S-T-R-I-K-E-Aerospace/Cansat_Huitzilin/Documentacion/CADGeneral.png

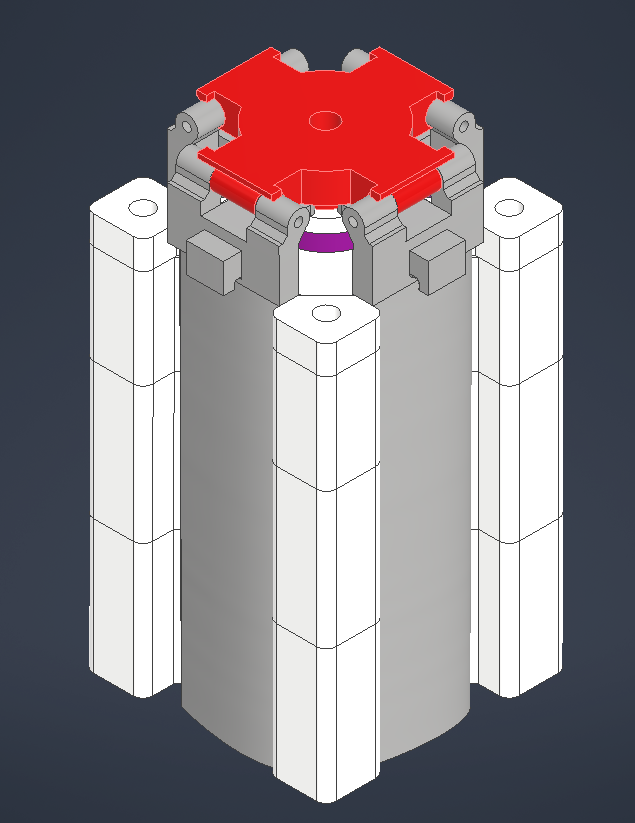
Documentacion/CADGeneral.png
