S-T-R-I-K-E-Aerospace/Cansat_Huitzilin/Documentacion/Semillas y AGua.png

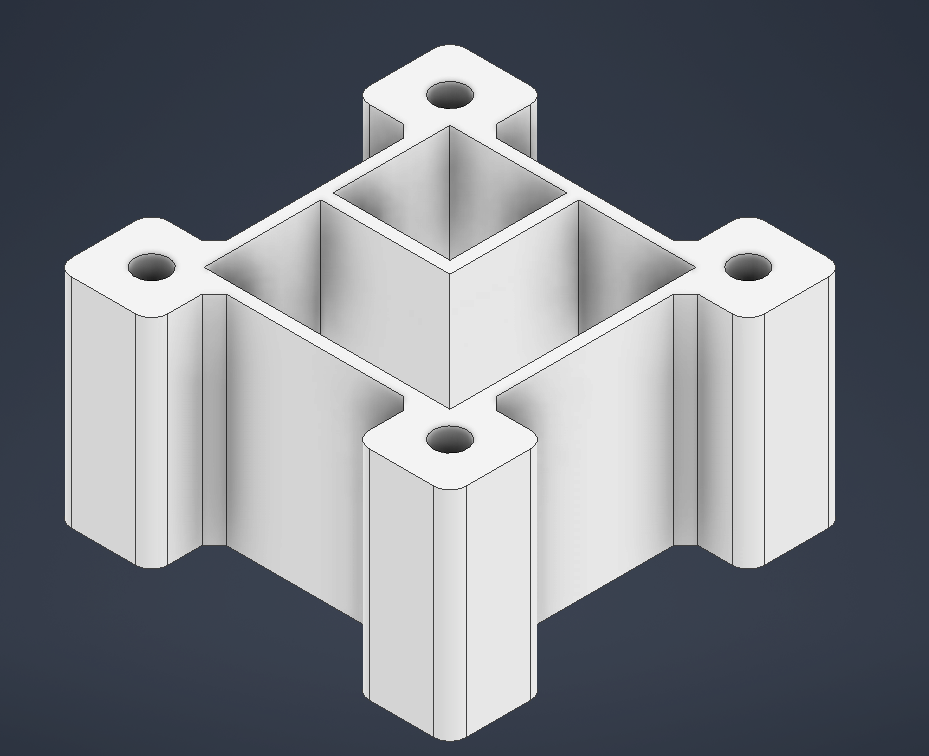
Documentacion/Semillas y AGua.png
