S-T-R-I-K-E-Aerospace/Cansat_Huitzilin/Documentacion/Huevo.png

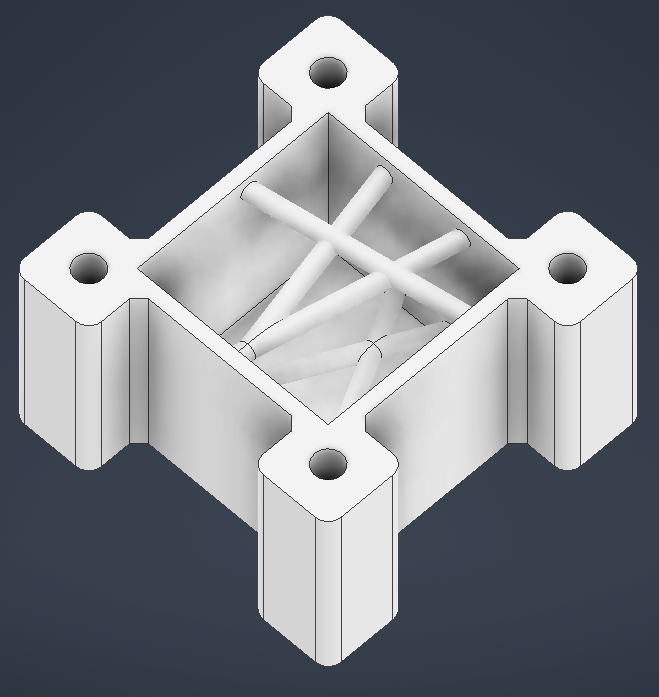
Documentacion/Huevo.png
