S-T-R-I-K-E-Aerospace/Cansat_Huitzilin/Documentacion/interfaz.png

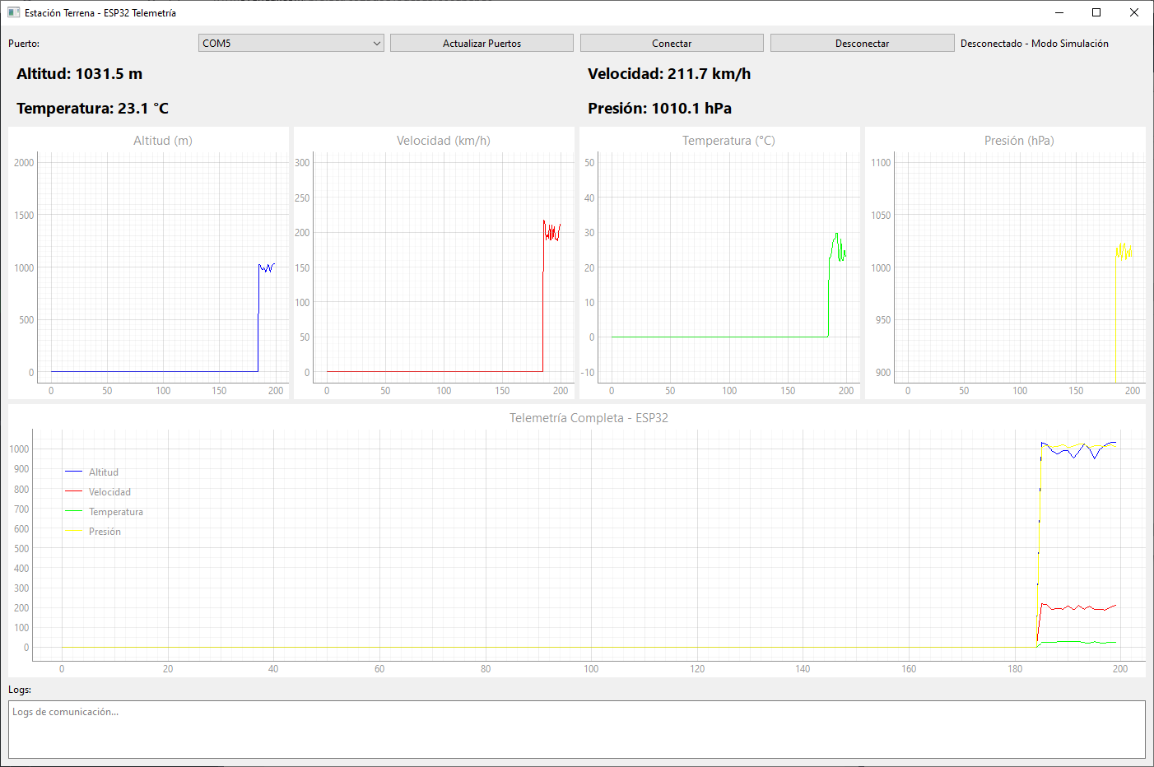
Documentacion/interfaz.png
