S-T-R-I-K-E-Aerospace/Cansat_Huitzilin/Documentacion/PalaDelantera.png

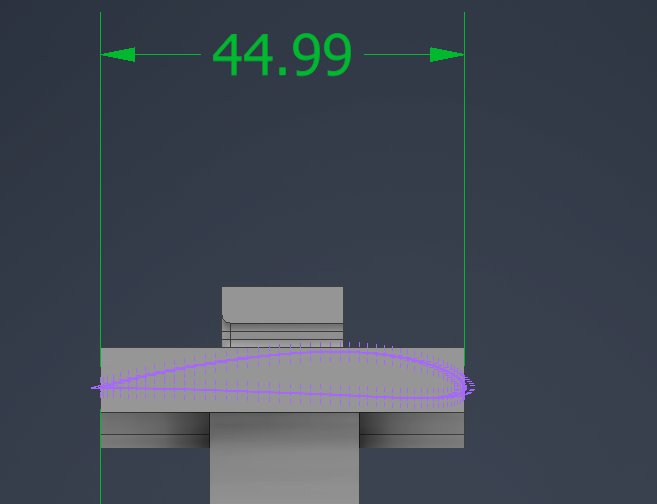
Documentacion/PalaDelantera.png
