S-T-R-I-K-E-Aerospace/Cansat_Huitzilin/Documentacion/Palalateral.png

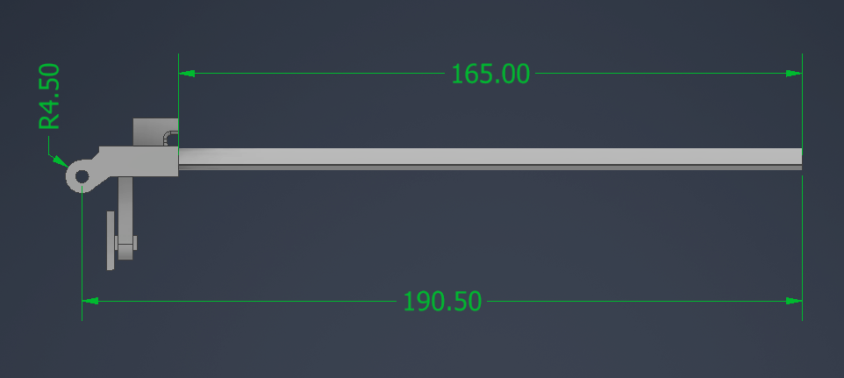
Documentacion/Palalateral.png
