S-T-R-I-K-E-Aerospace/Cansat_Huitzilin/Documentacion/Sistema Autogiro.png

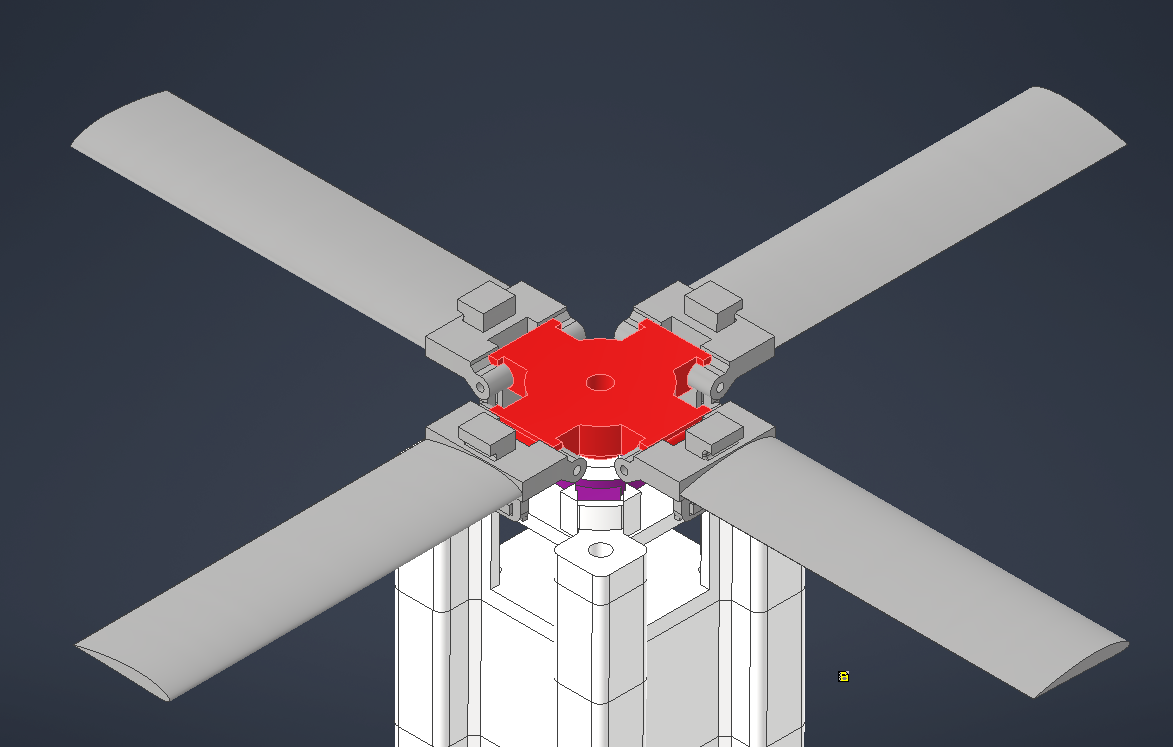
Documentacion/Sistema Autogiro.png
