S-T-R-I-K-E-Aerospace/Cansat_Huitzilin/(list of files, cad)

Other CAD files:
3D/Cansat armado.iam
3D/NuevoDiseno/628-ZZ-TheTimkenCompany-3D-01-17-2026.ipt
3D/NuevoDiseno/Arandela1-4.ipt
3D/NuevoDiseno/ArandelaDeCaucho.ipt
3D/NuevoDiseno/ArmellaCerrada.ipt
3D/NuevoDiseno/Huevo.ipt
3D/NuevoDiseno/Pala.ipt
3D/NuevoDiseno/SistemLiberacion1.ipt
3D/NuevoDiseno/SistemaDeDesacople.ipt
3D/NuevoDiseno/SubSistemaLiberacion.iam
3D/NuevoDiseno/SujeccionHelices.ipt
3D/NuevoDiseno/Tuerca1-4.ipt
3D/Pieza1.ipt
3D/Pieza2.ipt
3D/Pieza3.ipt
3D/Pieza4.ipt
3D/Pieza5.ipt
3D/Pieza6.ipt
3D/Pieza7.ipt
3D/Pieza8.ipt
3D/Pieza9.ipt
