S-T-R-I-K-E-Aerospace/Cansat_Huitzilin/PCB/Cansat_Huitzilin/Cansat_Huitzilin.kicad_pcb

## KiCad design PCB/Cansat_Huitzilin/Cansat_Huitzilin.kicad_pcb (2026-04-22)

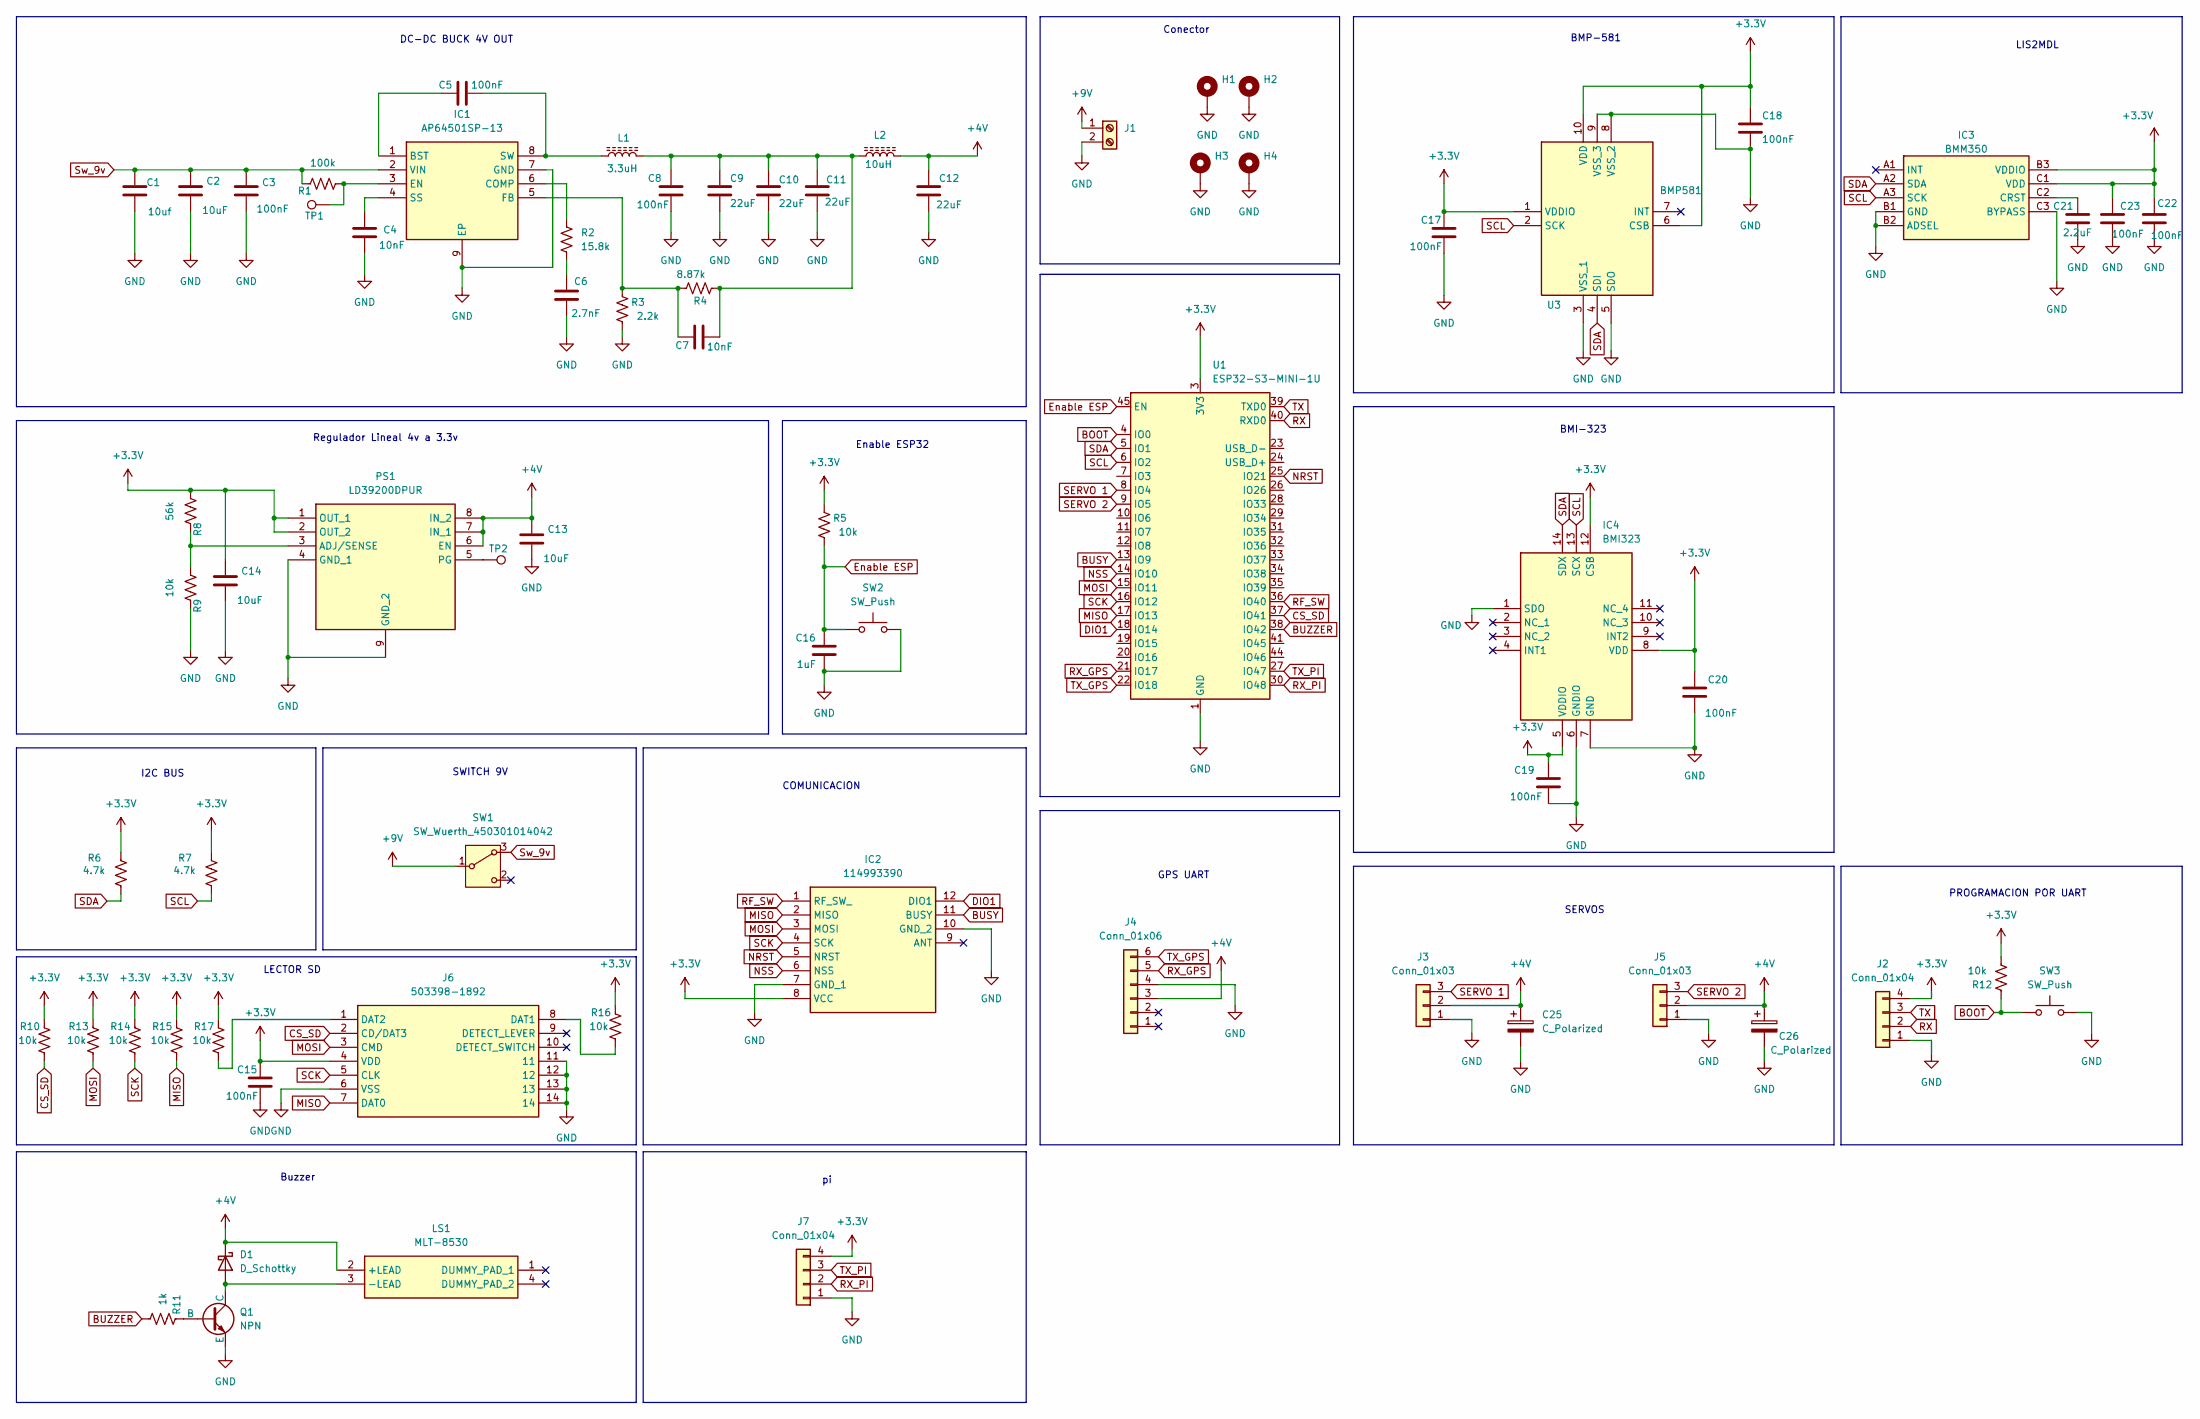
[picture p8: schematic Cansat_Huitzilin.kicad_sch, SCH_Cansat-Huitzilin]

Parts:
C1: 10uf; C_0603_1608Metric; Part Number CL10A106MA8NRNC
C2, C13, C14: 10uF; C_0603_1608Metric; Part Number CL10A106MA8NRNC
C3, C5, C8, C15, C17, C18, C19, C20, C22, C23: 100nF; C_0603_1608Metric; Part Number E0603X7R104K500NTD
C4, C7: 10nF; C_0603_1608Metric; Part Number C0201X7R103K500NTA
C6: 2.7nF; C_0603_1608Metric; Part Number C0603C272K5RACTU
C9, C10, C11, C12: 22uF; C_0603_1608Metric
C16: 1uF; C_0603_1608Metric; Part Number CL31B105KBHNNNE
C21: 2.2uF; C_0603_1608Metric; Part Number CL10E224KA84PNC
C25, C26: C_Polarized; CP_Elec_6.3x5.8; Part Number UUD1E101MCL1GS
D1: D_Schottky; D_SOD-123F; Part Number DSS14U
H1, H2, H3, H4: MountingHole_Pad; MountingHole_3.2mm_M3_Pad_Via
IC1: AP64501SP-13; SOIC-8-1EP_3.9x4.9mm_P1.27mm_EP2.29x3mm; Manufacturer_Part_Number AP64501SP-13; Mouser Part Number 621-AP64501SP-13
IC2: 114993390; Mouser Part Number 713-114993390
IC3: BMM350; BGA9C40P3X3_128X128X54; Manufacturer_Part_Number BMM350; Mouser Part Number 262-BMM350
IC4: BMI323; Manufacturer_Part_Number BMI323; Mouser Part Number 262-BMI323
J1: Screw_Terminal_01x02; TerminalBlock_MaiXu_MX126-5.0-02P_1x02_P5.00mm
J2, J7: Conn_01x04; PinHeader_1x04_P2.54mm_Vertical
J3, J5: Conn_01x03; PinHeader_1x03_P2.54mm_Vertical
J4: Conn_01x06; SM06BPASSTBTLFSN
J6: 503398-1892; 5033981892; Manufacturer_Part_Number 503398-1892; Mouser Part Number 538-503398-1892
L1: 3.3uH; L_Wuerth_WE-PD-Typ-LS; Part Number 7447779003
L2: 10uH; L_1210_3225Metric_Pad1.42x2.65mm_HandSolder
LS1: MLT-8530; MLT8530; Manufacturer_Part_Number MLT-8530
PS1: LD39200DPUR; SON80P400X400X100-9N-D; Mouser Part Number 511-LD39200DPUR
Q1: NPN; SOT-23; Part Number S8050
R1: 100k; R_0603_1608Metric; Part Number RC0805FR-07100KL
R2: 15.8k; R_0603_1608Metric; Part Number RMCF0805FT15K8
R3: 2.2k; R_0603_1608Metric; Part Number CRG0805F2K2
R4: 8.87k; R_0603_1608Metric; Part Number RC0805FR-078K87L
R5, R10, R12, R13, R14, R15, R16, R17: 10k; R_0603_1608Metric; Part Number CRCW080510K0FKEA
R6, R7: 4.7k; R_0603_1608Metric; Part Number CRCW08054K70FKEAC
R8: 56k; R_0603_1608Metric; Part Number RC0805FR-07100KL
R9: 10k; R_0603_1608Metric; Part Number RC0805FR-07100KL
R11: 1k; R_0603_1608Metric; Part Number CRCW080510K0FKEA
SW1: SW_Wuerth_450301014042; SW_Slide-03_Wuerth-WS-SLTV_10x2.5x6.4_P2.54mm
SW2, SW3: SW_Push; SW_SPST_SKQG_WithoutStem
TP1, TP2: TestPoint; TestPoint_Pad_D1.0mm
U1: ESP32-S3-MINI-1U; ESP32-S2-MINI-1U
U3: BMP581; Manufacturer_Part_Number BMP581; Mouser Part Number 262-BMP581

Connections:
+3.3V: C14.1, C15.1, C17.1, C18.1, C19.1, C20.1, C22.2, C23.1, IC2.8 (VCC), IC3.B3 (VDDIO), IC3.C1 (VDD), IC4.5 (VDDIO), IC4.8 (VDD), IC4.12 (CSB), J2.4, J6.4 (VDD), J7.4, PS1.1 (OUT_1), PS1.2 (OUT_2), R5.2, R6.1, R7.1, R8.2, R10.2, R12.1, R13.2, R14.2, R15.2, R16.2, R17.2, U1.3 (3V3), U3.1 (VDDIO), U3.6 (CSB), U3.10 (VDD)
+4V: C12.1, C13.1, C25.1, C26.1, D1.1 (K), J3.2, J4.3, J5.2, L2.2, LS1.2 (+LEAD), PS1.6 (EN), PS1.7 (IN_1), PS1.8 (IN_2)
+9V: J1.1, SW1.1 (B)
BOOT: R12.2, SW3.1, U1.4 (IO0)
BUSY: IC2.11 (BUSY), U1.13 (IO9)
BUZZER: R11.1, U1.38 (IO42)
CS_SD: J6.2 (CD/DAT3), R10.1, U1.37 (IO41)
DIO1: IC2.12 (DIO1), U1.18 (IO14)
Enable ESP: C16.1, R5.1, SW2.1, U1.45 (EN)
GND: C1.2, C2.2, C3.2, C4.2, C6.2, C8.2, C9.2, C10.2, C11.2, C12.2, C13.2, C14.2, C15.2, C16.2, C17.2, C18.2, C19.2, C20.2, C21.2, C22.1, C23.2, C25.2, C26.2, H1.1, H2.1, H3.1, H4.1, IC1.7 (GND), IC1.9 (EP), IC2.7 (GND_1), IC2.10 (GND_2), IC3.B1 (GND), IC3.B2 (ADSEL), IC3.C3 (BYPASS), IC4.1 (SDO), IC4.6 (GNDIO), IC4.7 (GND), J1.2, J2.1, J3.1, J4.4, J5.1, J6.6 (VSS), J6.11, J6.12, J6.13, J6.14, J7.1, PS1.4 (GND_1), PS1.9 (GND_2), Q1.3 (E), R3.1, R9.1, SW2.2, SW3.2, U1.1 (GND), U1.2 (GND), U1.42 (GND), U1.43 (GND), U1.46 (GND), U1.47 (GND), U1.48 (GND), U1.49 (GND), U1.50 (GND), U1.51 (GND), U1.52 (GND), U1.53 (GND), U1.54 (GND), U1.55 (GND), U1.56 (GND), U1.57 (GND), U1.58 (GND), U1.59 (GND), U1.60 (GND), U1.61 (GND), U1.62 (GND), U1.63 (GND), U1.64 (GND), U1.65 (GND), U3.3 (VSS_1), U3.5 (SDO), U3.8 (VSS_2), U3.9 (VSS_3)
MISO: IC2.2 (MISO), J6.7 (DAT0), R15.1, U1.17 (IO13)
MOSI: IC2.3 (MOSI), J6.3 (CMD), R13.1, U1.15 (IO11)
NRST: IC2.5 (NRST), U1.25 (IO21)
NSS: IC2.6 (NSS), U1.14 (IO10)
unnamed: C6.1, R2.1
unnamed: C7.2, C8.1, C9.1, C10.1, C11.1, L1.2, L2.1, R4.1
unnamed: D1.2 (A), LS1.3 (-LEAD), Q1.1 (C)
unnamed: C5.1, IC1.1 (BST)
unnamed: IC1.6 (COMP), R2.2
unnamed: IC1.3 (EN), R1.2, TP1.1
unnamed: C7.1, IC1.5 (FB), R3.2, R4.2
unnamed: C4.1, IC1.4 (SS)
unnamed: C5.2, IC1.8 (SW), L1.1
unnamed: C21.1, IC3.C2 (CRST)
unnamed: J6.8 (DAT1), R16.1
unnamed: J6.1 (DAT2), R17.1
unnamed: PS1.3 (ADJ/SENSE), R8.1, R9.2
unnamed: PS1.5 (PG), TP2.1
unnamed: Q1.2 (B), R11.2
RF_SW: IC2.1 (RF_SW_), U1.36 (IO40)
RX: J2.2, U1.40 (RXD0)
RX_GPS: J4.5, U1.21 (IO17)
RX_PI: J7.2, U1.30 (IO48)
SCK: IC2.4 (SCK), J6.5 (CLK), R14.1, U1.16 (IO12)
SCL: IC3.A3 (SCK), IC4.13 (SCX), R7.2, U1.6 (IO2), U3.2 (SCK)
SDA: IC3.A2 (SDA), IC4.14 (SDX), R6.2, U1.5 (IO1), U3.4 (SDI)
SERVO 1: J3.3, U1.8 (IO4)
SERVO 2: J5.3, U1.9 (IO5)
Sw_9v: C1.1, C2.1, C3.1, IC1.2 (VIN), R1.1, SW1.3 (A)
TX: J2.3, U1.39 (TXD0)
TX_GPS: J4.6, U1.22 (IO18)
TX_PI: J7.3, U1.27 (IO47)

Notes on the sheet:
LECTOR SD
BMI-323
PROGRAMACION POR UART
I2C BUS
GPS UART
Regulador Lineal 4v a 3.3v
BMP-581
SWITCH 9V
DC-DC BUCK 4V OUT
LIS2MDL
COMUNICACION
Conector
Buzzer
Enable ESP32
SERVOS

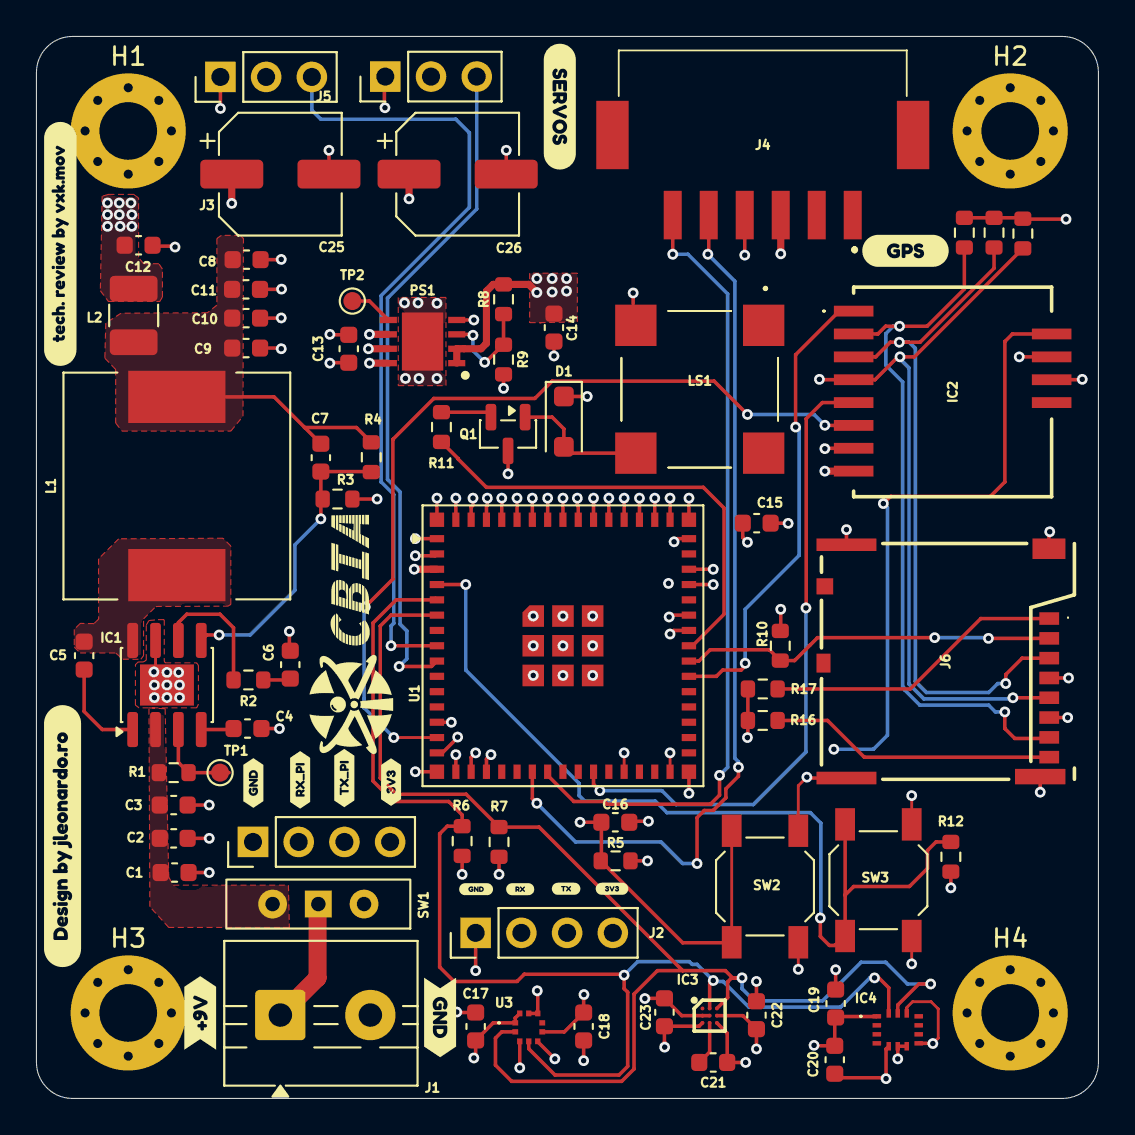
[picture p9: board Cansat_Huitzilin.kicad_pcb from above]

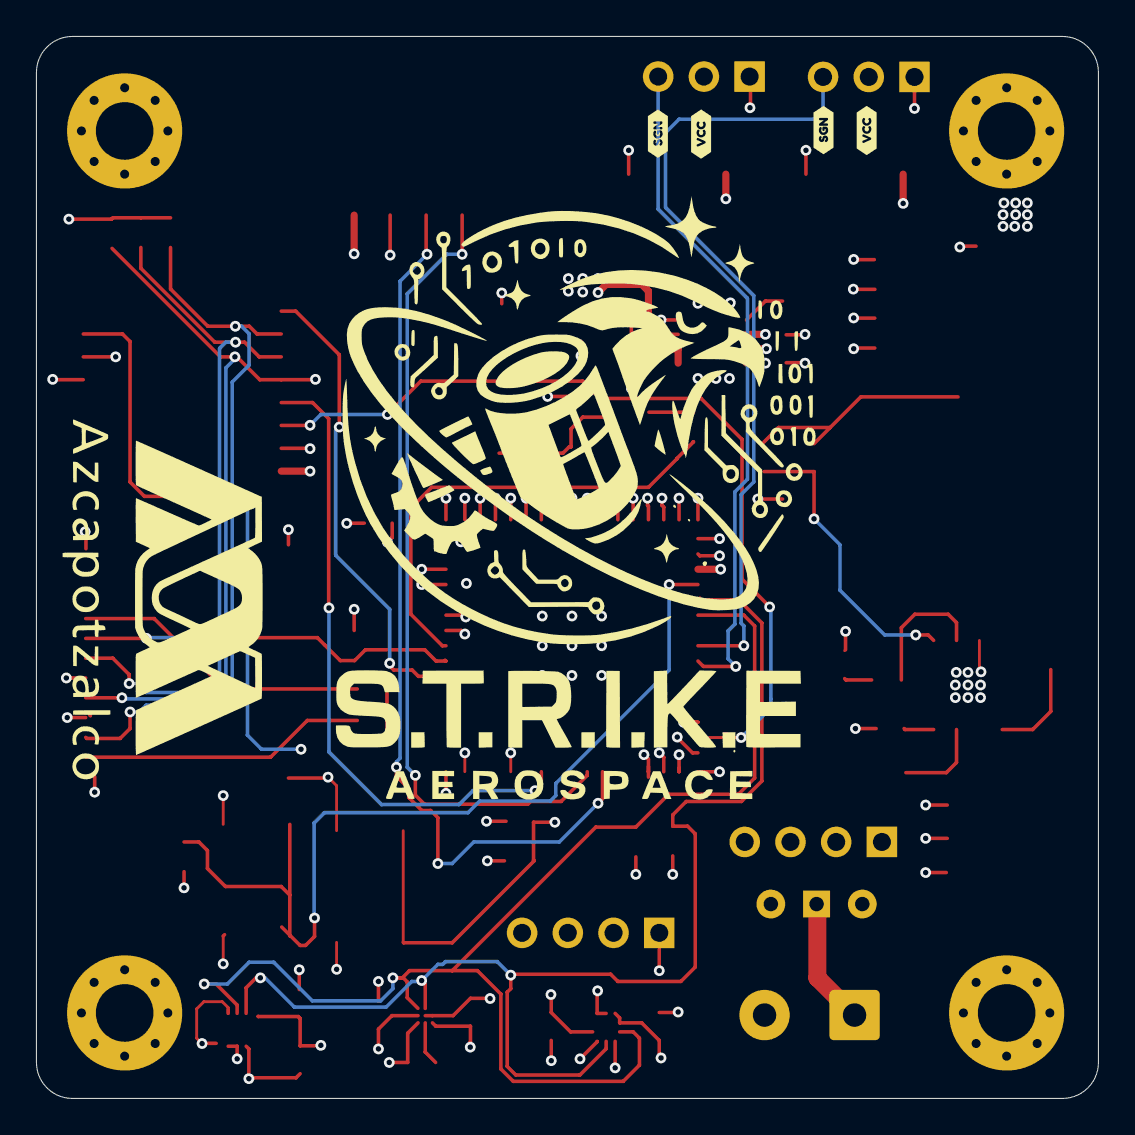
[picture p10: board Cansat_Huitzilin.kicad_pcb from below]

Board: 4 copper layers, 59.0 x 59.0 mm, 88 parts (4 on the bottom side), 42 nets.

Other parts of the board:
kibuzzard-69ACDBDC: G***; kibuzzard-69ACDBDC
kibuzzard-69ACDC11: G***; kibuzzard-69ACDC11
kibuzzard-69ACDC24: G***; kibuzzard-69ACDC24
kibuzzard-69ACDC57: G***; kibuzzard-69ACDC57
kibuzzard-69ACDEB2, kibuzzard-69ACDEB2#2: G***; kibuzzard-69ACDEB2
kibuzzard-69ACDECD, kibuzzard-69ACDECD#2: G***; kibuzzard-69ACDECD
kibuzzard-69ADC2FE: G***; kibuzzard-69ADC2FE
kibuzzard-69ADC3B5: G***; kibuzzard-69ADC3B5
kibuzzard-69ADC4A7: G***; kibuzzard-69ADC4A7
kibuzzard-69ADC45A: G***; kibuzzard-69ADC45A
kibuzzard-69ADC49F: G***; kibuzzard-69ADC49F
kibuzzard-69ADC375: G***; kibuzzard-69ADC375
kibuzzard-69ADC389: G***; kibuzzard-69ADC389
kibuzzard-69ADC495: G***; kibuzzard-69ADC495
kibuzzard-69CE0A89: G***; kibuzzard-69CE0A89
kibuzzard-69CE31E7: G***; kibuzzard-69CE31E7
