S-T-R-I-K-E-Aerospace/Cansat_Huitzilin/(commit log)

2025-10-29 create kicadprj and add 3dmodels
    [Cansat armado.iam, Cansat_Huitzilin.kicad_pcb, Cansat_Huitzilin.kicad_sch, Pieza1.ipt, Pieza2.ipt, Pieza3.ipt, Pieza4.ipt, Pieza5.ipt]
2025-11-10 start new design
    [Pieza4.ipt, SistemLiberacion1.ipt, SujeccionHelices.0001.ipt, SujeccionHelices.ipt]
2025-11-12 aero
    define the new dimensions of NACA profiles
    [Ensamblaje5.0001.iam, Ensamblaje5.iam, Pieza9.0002.ipt, Pieza9.ipt, SistemLiberacion1.0001.ipt, SistemLiberacion1.ipt, SistemLiberacion2.0003.ipt, SistemLiberacion2.ipt]
2025-11-14 more or less
    i finished the naca profiles and the support of the profiles and start a enclousure for de deployment system
    [Ensamblaje5.0001.iam, Ensamblaje5.0005.iam, Ensamblaje5.iam, NACA4412.stl, Pieza9.0002.ipt, Pieza9.0013.ipt, Pieza9.ipt, SistemLiberacion1.0001.ipt]
2025-11-16 finish 3d model
    finish the 3d modelling and the 3d assembly
    [Cansat armado.0008.iam, Cansat armado.0009.iam, Cansat armado.iam, Electronica.0004.ipt, Electronica.ipt, Ensamblaje5.0005.iam, Ensamblaje5.0013.iam, Ensamblaje5.iam]
2025-11-21 add 3d printable models
    [CE3V2NEO_Electronica.3mf, CE5P_NACA4412.3mf, Electronica.0008.ipt, Electronica.ipt, Electronica.stl, Ensamblaje5.0018.iam, Ensamblaje5.iam, Huevo.0004.ipt]
2025-12-01 little changes
    [Electronica.0008.ipt, Electronica.0009.ipt, Electronica.ipt, Electronica.stl, Ensamblaje5.0018.iam, Ensamblaje5.0023.iam, Ensamblaje5.iam, NACA4412.stl]
2025-12-09 make another files
    [Ensamblaje5.0023.iam, Ensamblaje5.0024.iam, Ensamblaje5.iam, ExpansorConexion.3mf, ExpansorConexion.stl, Huevo.0004.ipt, Huevo.0005.ipt, Huevo.ipt]
2025-12-09 save changes
    [SistemaLiberacion2.2.0026.ipt, SistemaLiberacion2.2.0027.ipt, SistemaLiberacion2.2.ipt, SubSistemaLiberacion.0002.iam, SubSistemaLiberacion.0003.iam, SubSistemaLiberacion.iam]
2025-12-09 Delete objets
    delete files
    delete files for a pull request
    [Electronica.ipt, Ensamblaje5.iam, Huevo.ipt, SemillasyAgua.ipt, SistemaLiberacion2.2.ipt, SujeccionHelices.ipt]
2025-12-09 Merge: Recuperando archivos de diseño desde feature/nuevasPiezas
    [Electronica.ipt, Ensamblaje5.0024.iam, Ensamblaje5.iam, ExpansorConexion.3mf, ExpansorConexion.stl, Huevo.0005.ipt, Huevo.ipt, InsertoM3.ipt]
2025-12-09 Cambios en Liberacion
    Cambios la sujeccion, se cambiaron las dimensiones de los tornillos, junto con un mejor ensamble.
    [Bearing 625 2RS.ipt, Ensamblaje5.0023.iam, Ensamblaje5.0024.iam, Ensamblaje5.0025.iam, Ensamblaje5.iam, InsertoM3.0001.ipt, InsertoM3.ipt, SubSistemaLiberacion.0003.iam]
2025-12-09 Modificaciones a Huevo
    Se hizo un empalme en toda la esctructura exterior
    [ExpansorConexion.stl, Huevo.0004.ipt, Huevo.0005.ipt, Huevo.0006.ipt, Huevo.ipt, Huevo.stl, SemillasyAgua.0003.ipt, SemillasyAgua.0004.ipt]
2026-01-20 Autogiro
    Se rediseñaron las piezas del sistema de autogiro ajustandolas a nuevas formas de sujetar las secciones.
    [Ensamblaje5.0024.iam, Ensamblaje5.iam, SistemLiberacion1.0013.ipt, SistemLiberacion1.ipt, SistemaLiberacion2.2.0027.ipt, SistemaLiberacion2.2.ipt, SubSistemaLiberacion.0003.iam, SubSistemaLiberacion.iam]
2026-01-20 Archivos
    limpieza de archivos
    [Arandela1-4.ipt, ArandelaDeCaucho.ipt, ArmellaCerrada.ipt, Electronica.0009.ipt, Ensamblaje5.iam, Huevo.0005.ipt, InsertoM3.ipt, Pala.0030.ipt]
2026-01-20 Prepare for merge
    Preparacion de archivos binarios para merge posterior
    [CE3V2NEO_Electronica.3mf, CE5P_NACA4412.3mf, Cansat armado.iam, Electronica.0009.ipt, Electronica.ipt, Electronica.stl, Ensamblaje5.0023.iam, Ensamblaje5.iam]
2026-01-20 prepare for merge
    [Bearing 625 2RS.ipt, Ensamblaje5.0025.iam, Ensamblaje5.iam, ExpansorConexion.3mf, ExpansorConexion.stl, Huevo.0006.ipt, Huevo.ipt, Huevo.stl]
2026-02-13 Actualización de la PCB
    [Cansat_Huitzilin.kicad_pcb, Cansat_Huitzilin.kicad_sch]
2026-02-14 Actualización del diseño PCB
    [Cansat_Huitzilin.kicad_pcb, Cansat_Huitzilin.kicad_sch]
2026-03-07 PCB
    Modify the track spacing
    [Cansat_Huitzilin.kicad_pcb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]
2026-03-07 PCB actualizado desde el esquemático
    [Cansat_Huitzilin.kicad_pcb]
2026-03-08 PCB
    adding the final serigraphy
    [Cansat_Huitzilin.kicad_pcb, Cansat_Huitzilin.kicad_sch]
2026-03-08 Modelo 3D
    [Cansat_Huitzilin.kicad_pcb]
2026-03-08 Agregando librerias al proyecto
    [Cansat_Huitzilin.kicad_pcb]
2026-03-10 GUI & PCB
    Complete Mission Control v1.0.1 and integrate final CanSat PCB + libraries
    [Cansat_Huitzilin.kicad_pcb, Cansat_Huitzilin.kicad_sch]
